ekorudiawan/DC-Motor-Bench/Document/Input_PLC_OK.pdf

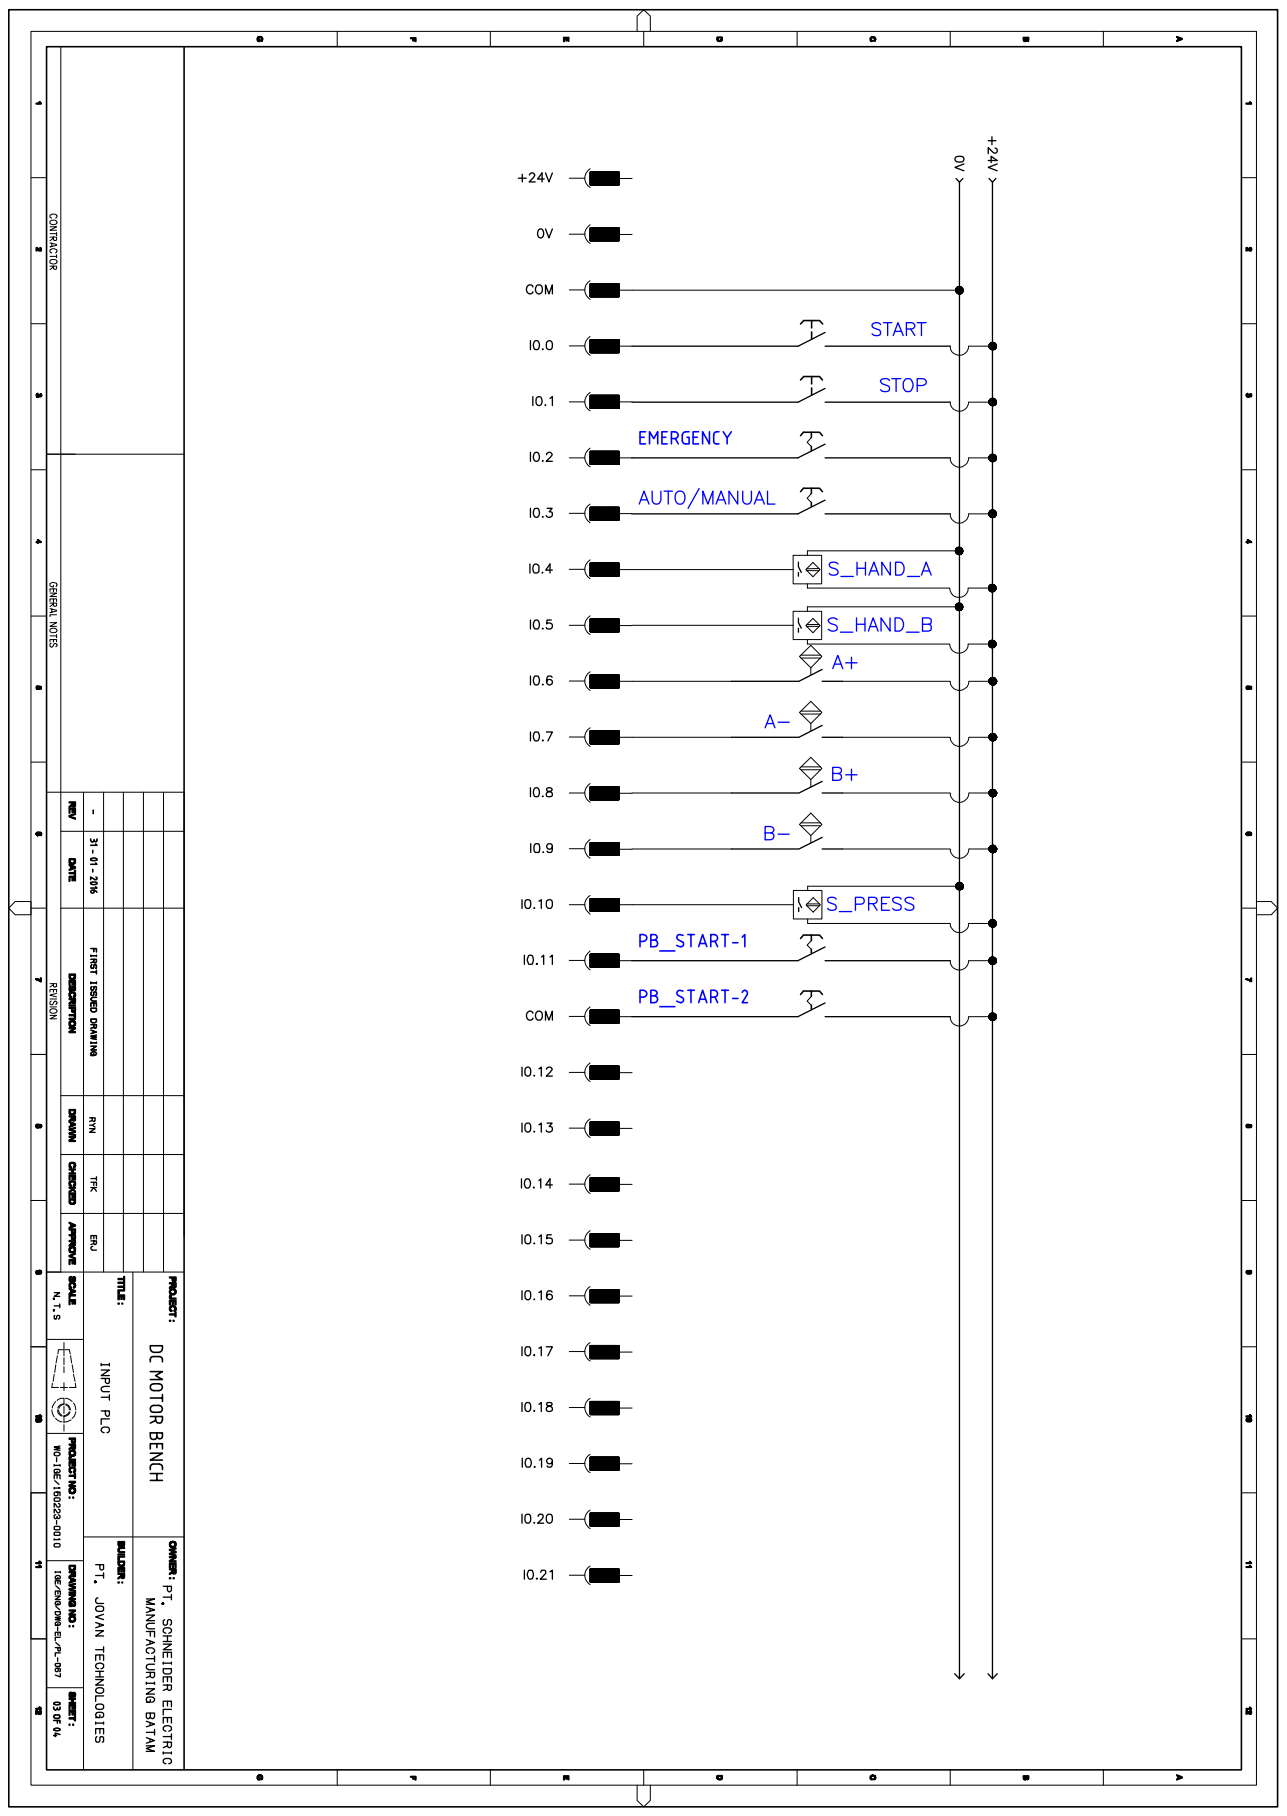
[picture p1: page 1]
