ekorudiawan/DC-Motor-Bench/Document/Output_PLC_OK.pdf

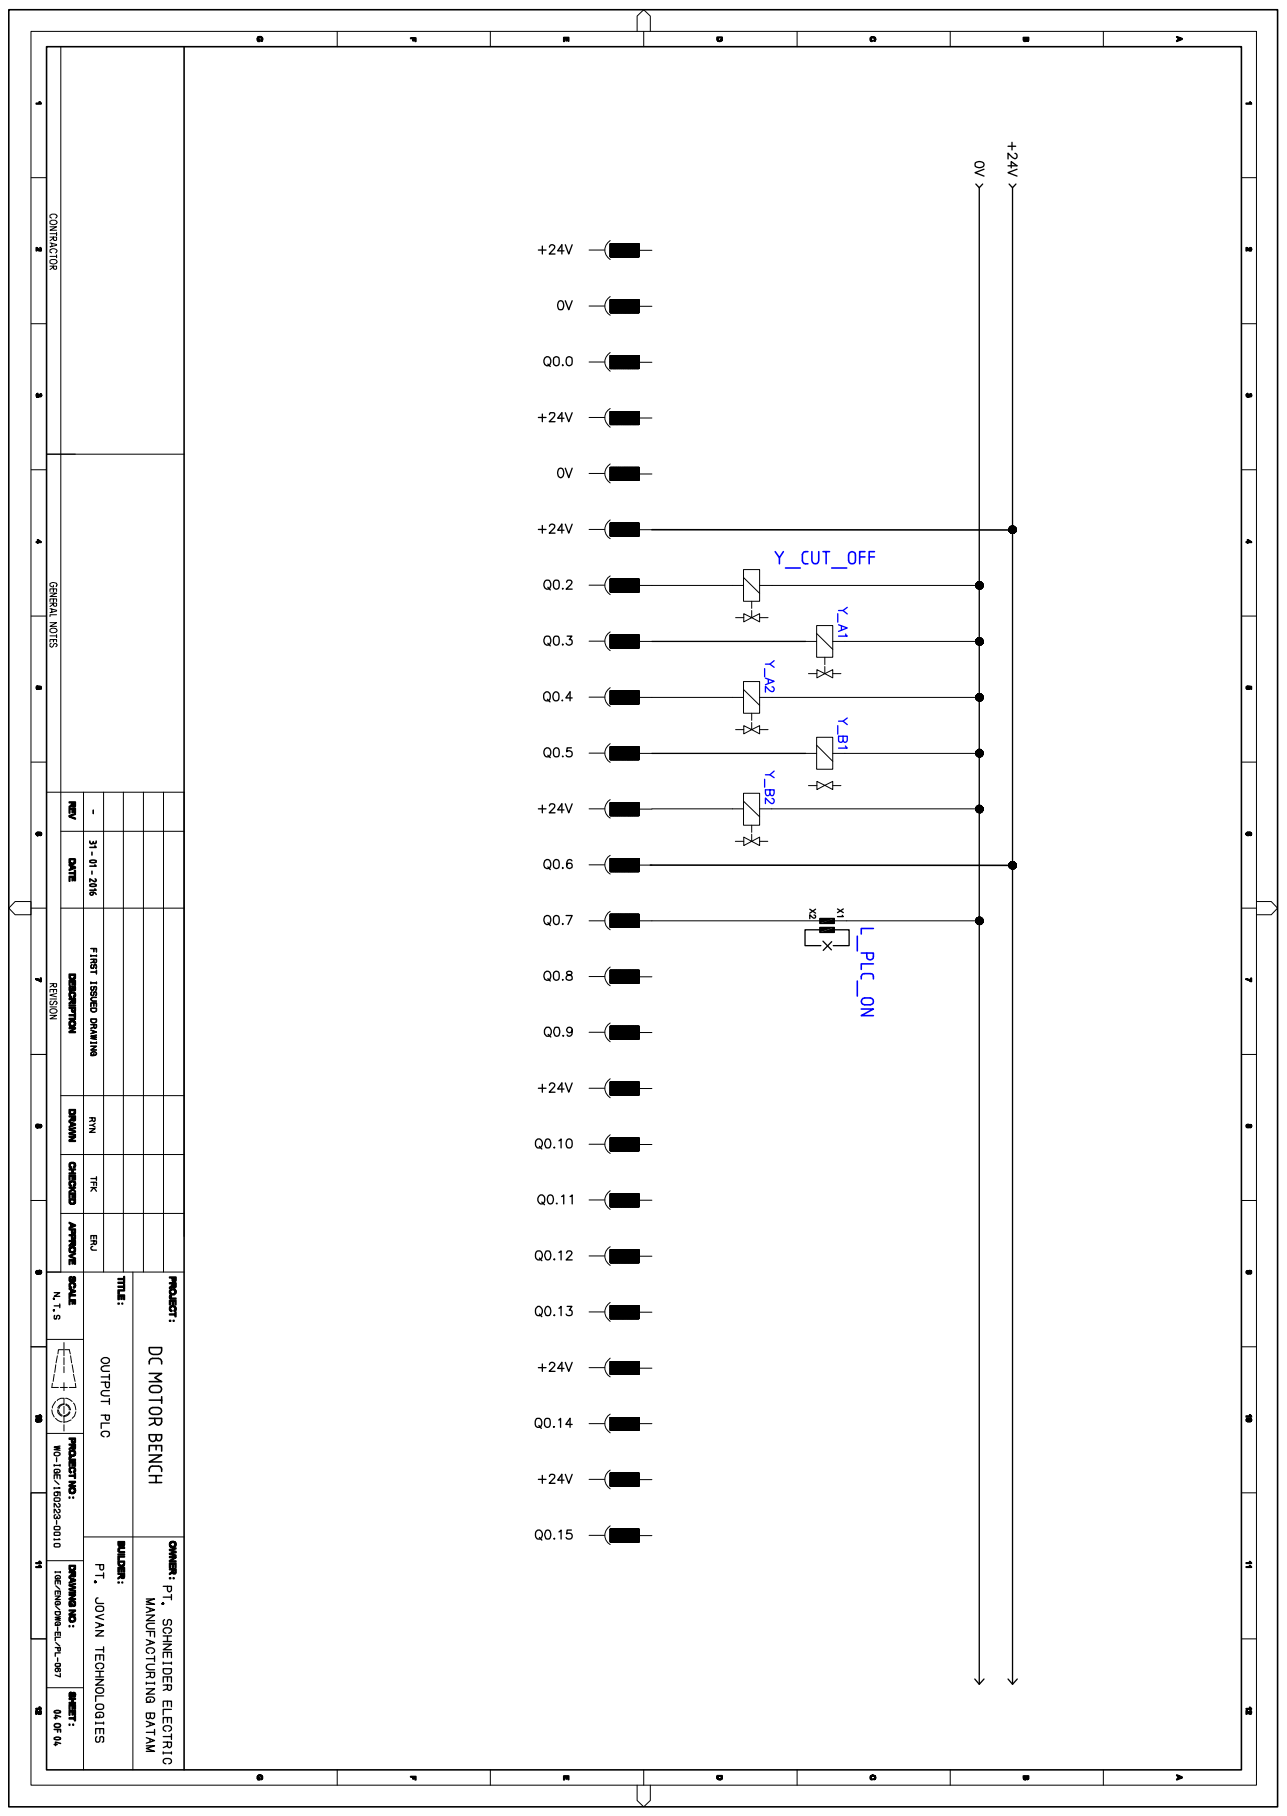
[picture p2: page 1]
