ekorudiawan/DC-Motor-Bench/Source Code/DC Motor Bench/thumbnail-dsc.bmp

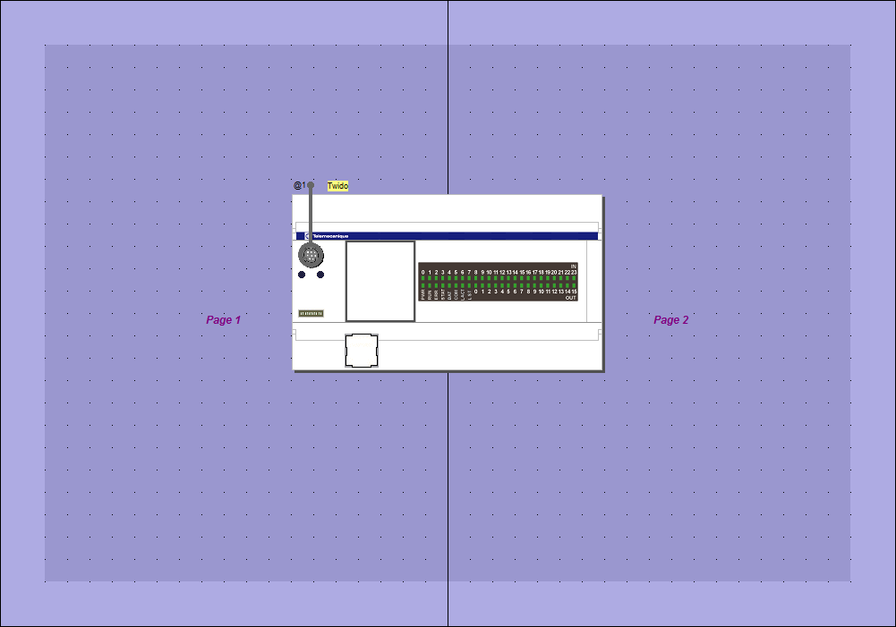
Source Code/DC Motor Bench/thumbnail-dsc.bmp
