ekorudiawan/DC-Motor-Bench/Document/Pneumatic Diagram.dxf

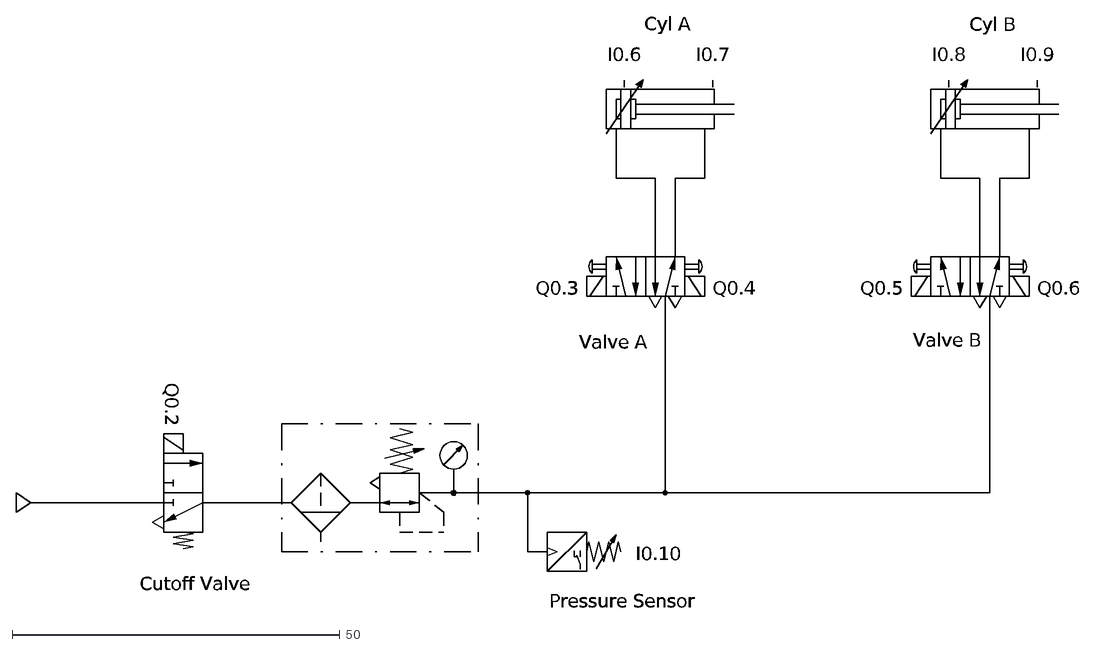
[picture p4: CAD file, 2016-10-16]
Document/Pneumatic Diagram.dxf
Q0.3
Q0.4
Q0.5
Q0.6
Q0.2
I0.6
I0.7
I0.8
I0.9
I0.10
Cyl A
Cyl B
Valve A
Valve B
Pressure Sensor
Cutoff Valve
