ekorudiawan/DC-Motor-Bench/(list of files, cad)

Other CAD files:
Document/Electric_SCH.dwg
Document/Panel_Box.dwg
