ekorudiawan/DC-Motor-Bench/Document/Panel_Box.pdf

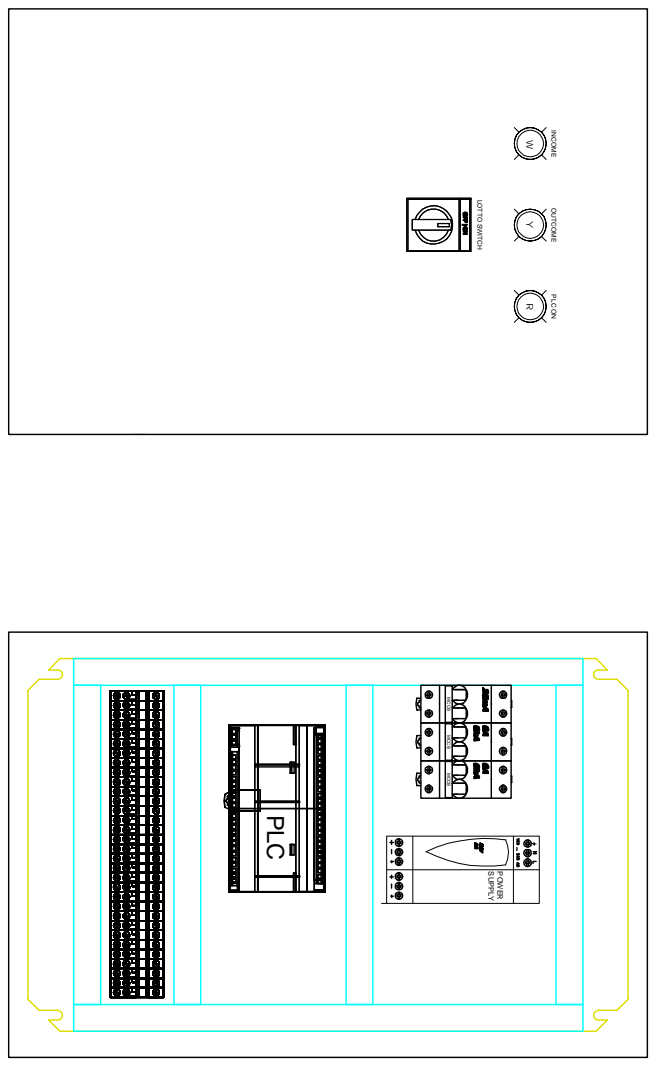
[picture p5: page 1]

W Y R PLC SUPPLY POWER INCOME OUTCOME PLC ON LOTTO SWITCH MCCB MCCB MCCB
