ekorudiawan/DC-Motor-Bench/Document/Electric_SCH_OK.pdf

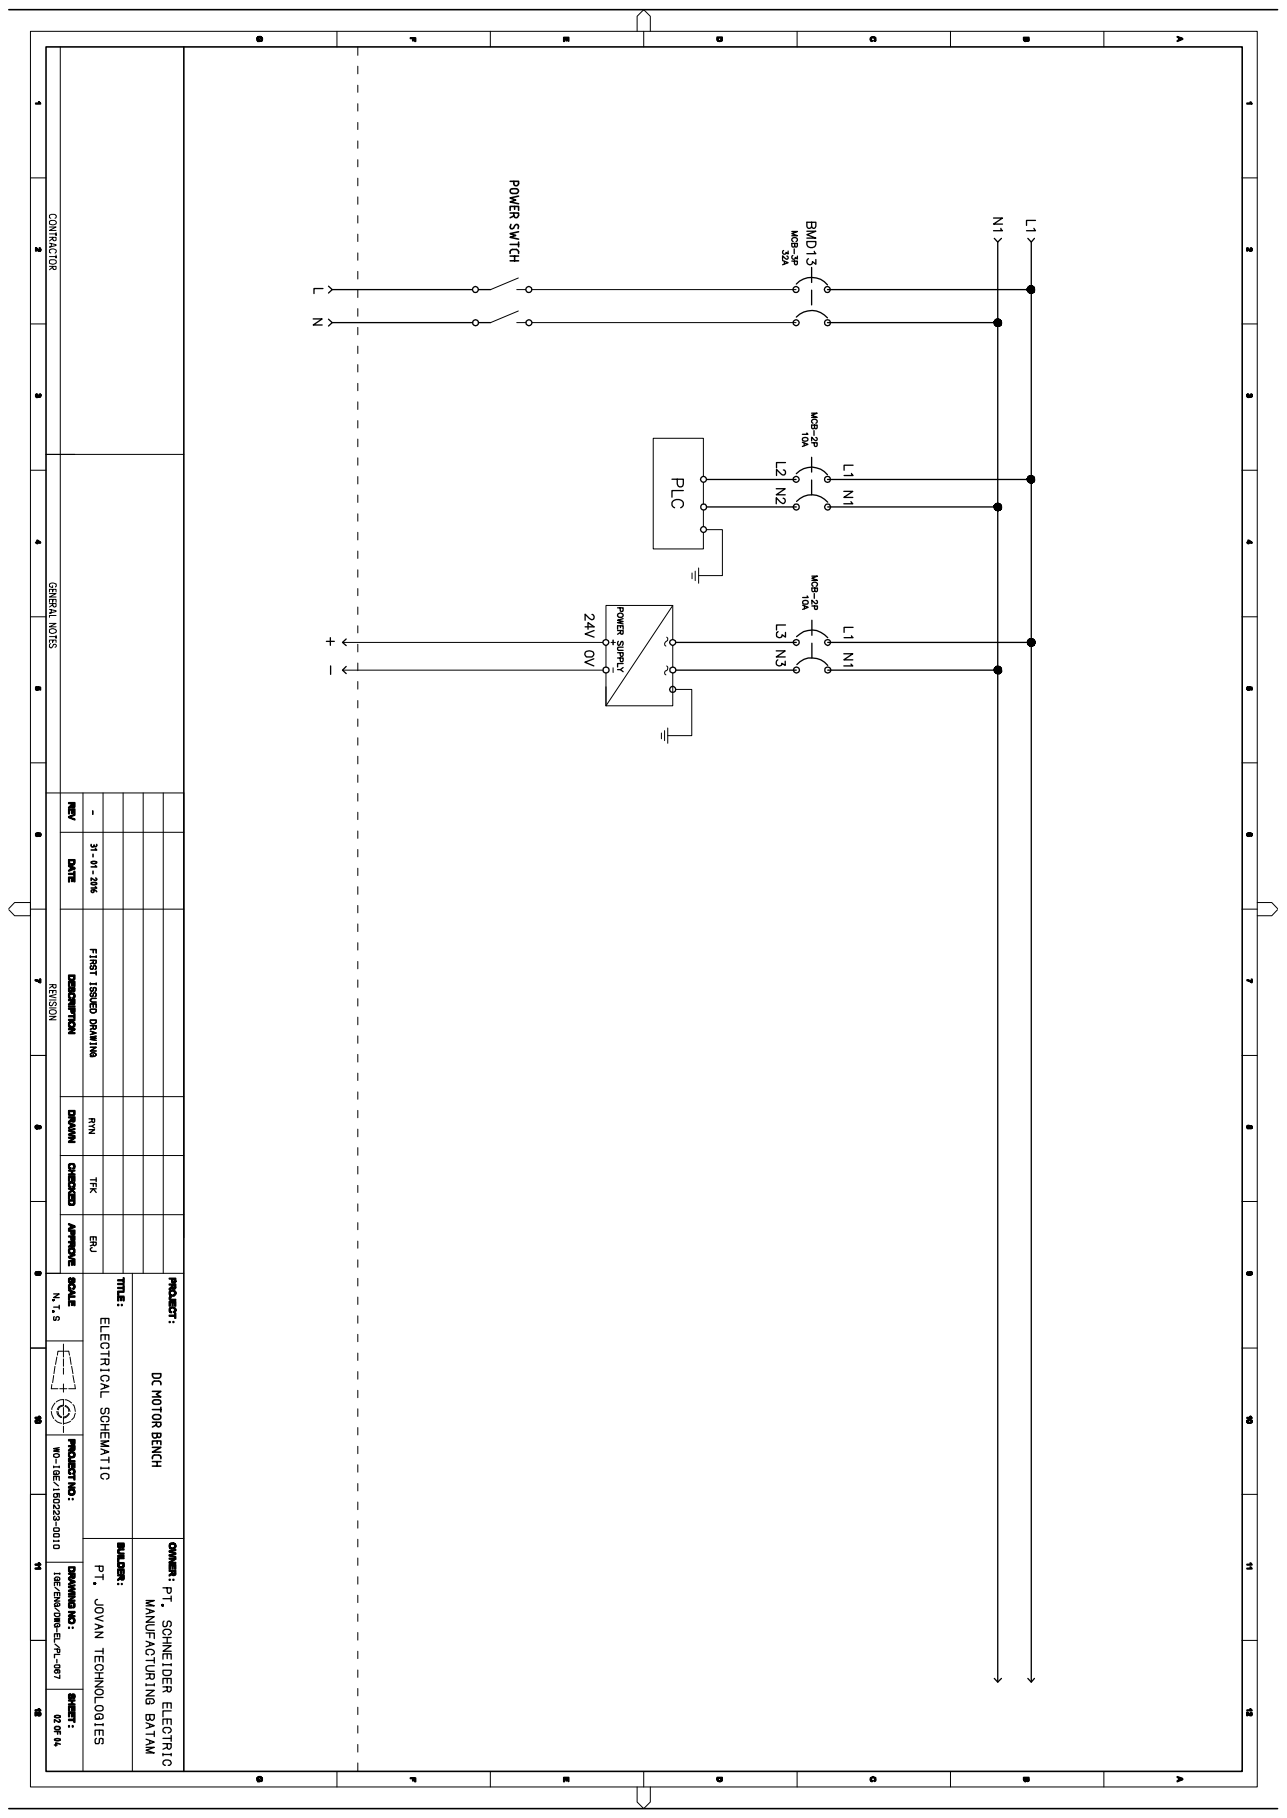
[picture p6: page 1]
