ekorudiawan/DC-Motor-Bench/Document/Panel_Box_OK.pdf

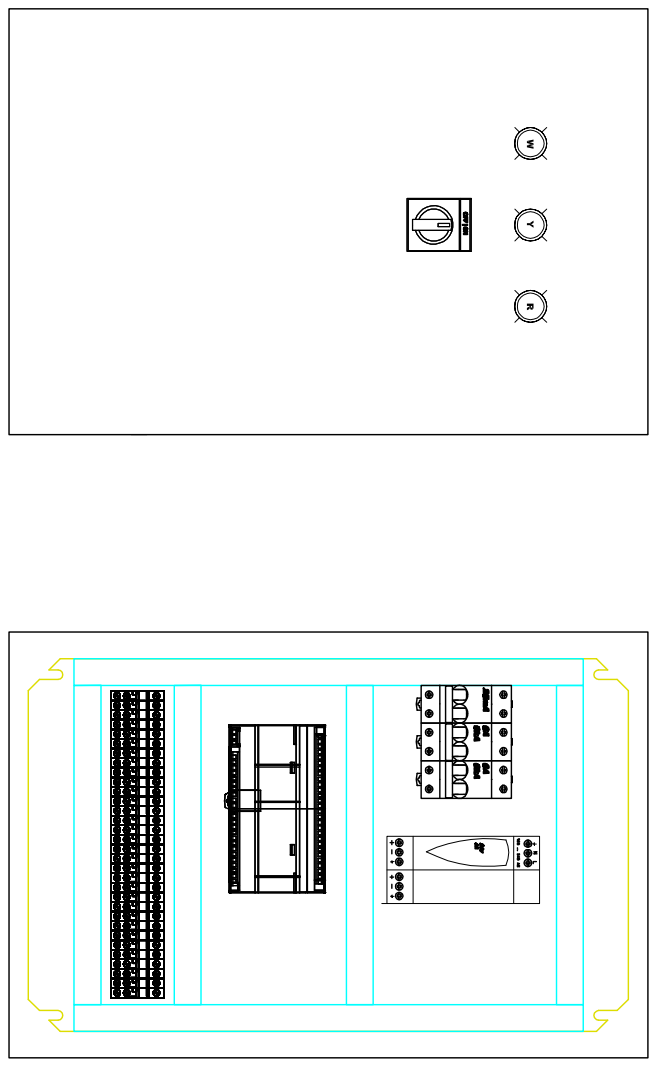
[picture p7: page 1]
