ekorudiawan/DC-Motor-Bench/Document/Pneumatic Diagram.pdf

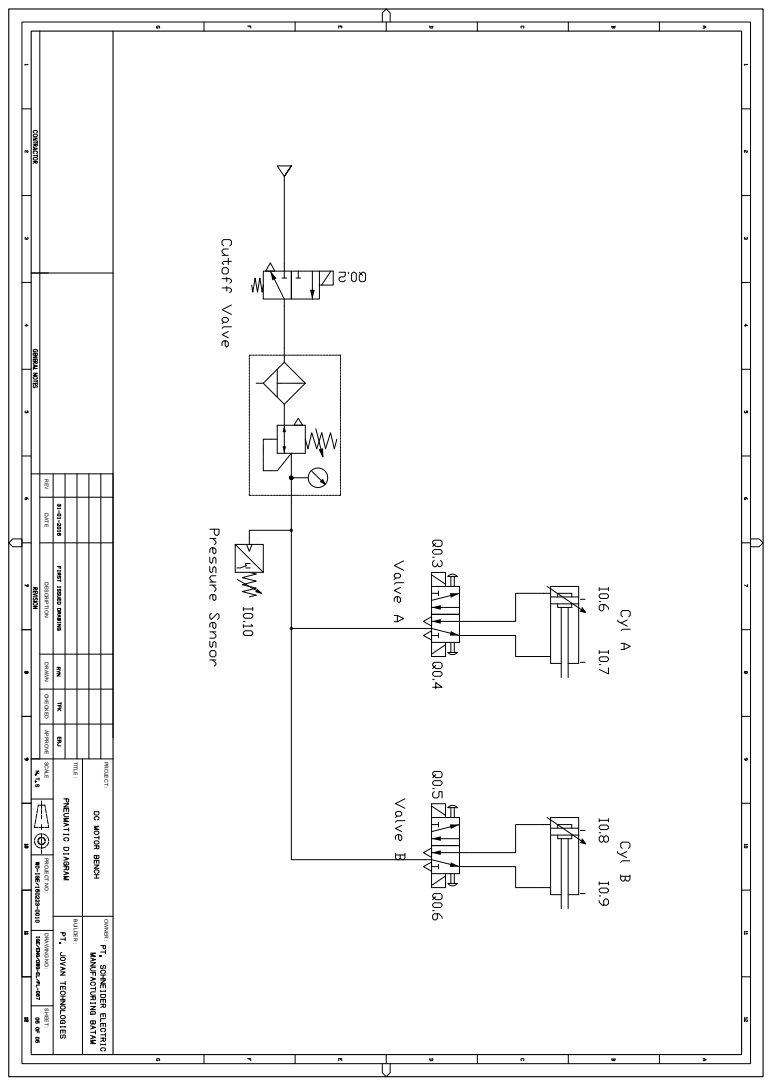
[picture p8: page 1]

REV DATE DESCRIPTION DRAWN CHECKED APPROVE SCALE PROJECT NO : DRAWING NO : SHEET : TITLE : PROJECT : BUILDER : OWNER :
